FieserKiller/EATON_MINI_UPS_SMARTIFIER/(threads)

Thread 1 (2022-09-12):

Arduino USB HID UPS

kOld, 2022-09-12:
Just discovered your project, great documentation 👍

Right away I remembered the HIDPowerDevice for Arduino Leonardo: https://github.com/abratchik/HIDPowerDevice

This way should be possible to use all the common tools that will shutdown the system when the charge state gets low, also it will gets a nice battery icon for the compatible OSes

I’m planning on buying a unit and trying to merge your code with the HID UPS example for state and percent reporting, but probably we won’t get any insights about remaining time without analyzing the power consumption in realtime with some current sensor

Thanks, Élio

FieserKiller, 2022-09-12:
Wow didn't know this existed! Share your progress pls, I'm curious if it'll work out fine.
You could roughly estimate remaining time by measuring the time between 2 LED state changes and interpolating to zero.That would be really rough but better then nothing I guess :)

kOld, 2022-09-13:
Definitely is better to have some estimate that nothing, I was thinking in using something like the acs712 current sensor, should be pretty simple to setup it up inline with the load

Anyway, I was looking into your pictures and I'm wondering if we have an UART interface available right here:
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

Did you try to use some logic analyser with this pins?

kOld, 2022-09-13:
Just a quick update, I've tested the library on a Arduino Pro Micro 16Mhz and it works brilliantly, at least under Mac OS X:
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
