FieserKiller/EATON_MINI_UPS_SMARTIFIER/(commit log)

2022-09-03 Fixed 38% battery level
    discharging at 38% was interpreted as nromal operation with 9V output
    [EATON_UPS_monitor.ino]
2022-09-05 image cut
2023-07-11 Update README.md
    switched LN tipping address
